hallihan/flighttrack/hardware/case/cover.stl

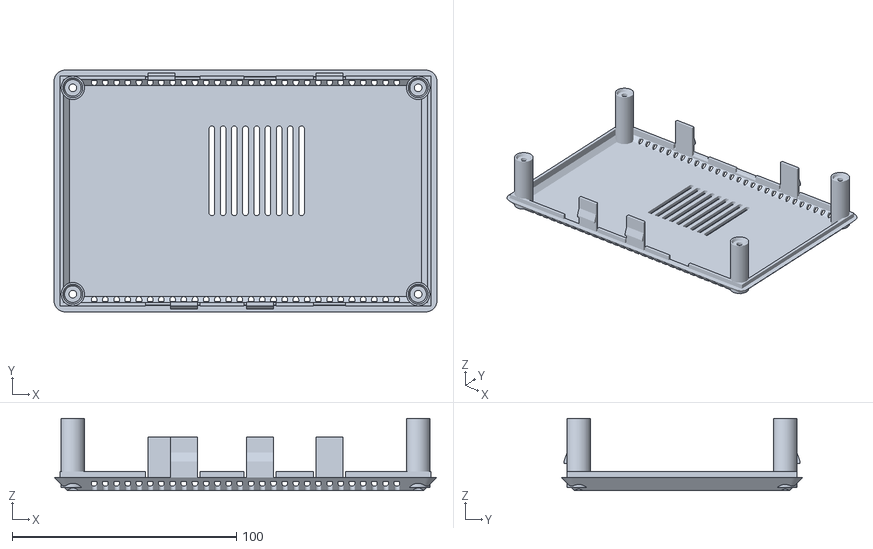
[picture p2: CAD file, 2026-10-16]
hardware/case/cover.stl
170.8 x 107.8 x 32.3
