hallihan/flighttrack/hardware/case/body.stl

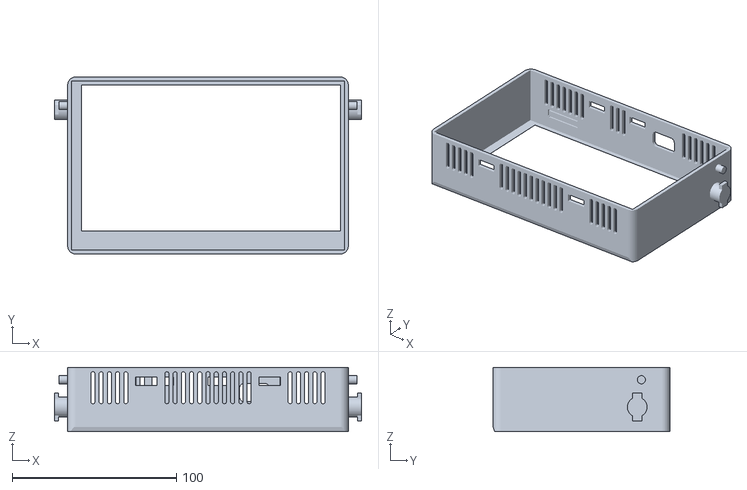
[picture p3: CAD file, 2026-10-16]
hardware/case/body.stl
186.8 x 107.8 x 39.2
