hallihan/flighttrack/hardware/case/wedgestand.stl

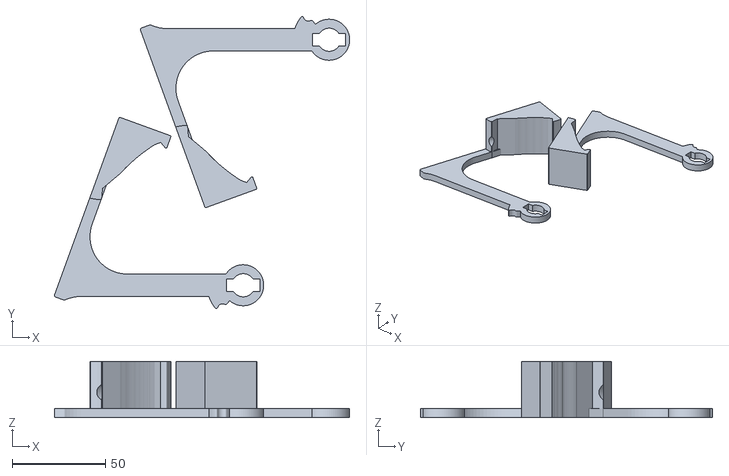
[picture p4: CAD file, 2026-10-16]
hardware/case/wedgestand.stl
158.1 x 156.3 x 30.2
