hallihan/flighttrack/(commit log)

2026-10-15 Settings pages, web page with password, Wi-Fi and power
2026-10-16 Case and wedge stands
    [body.stl, cover.stl, wedgestand.stl]
